Sergel1/dispolays/cad/Dispolays_kicad.step

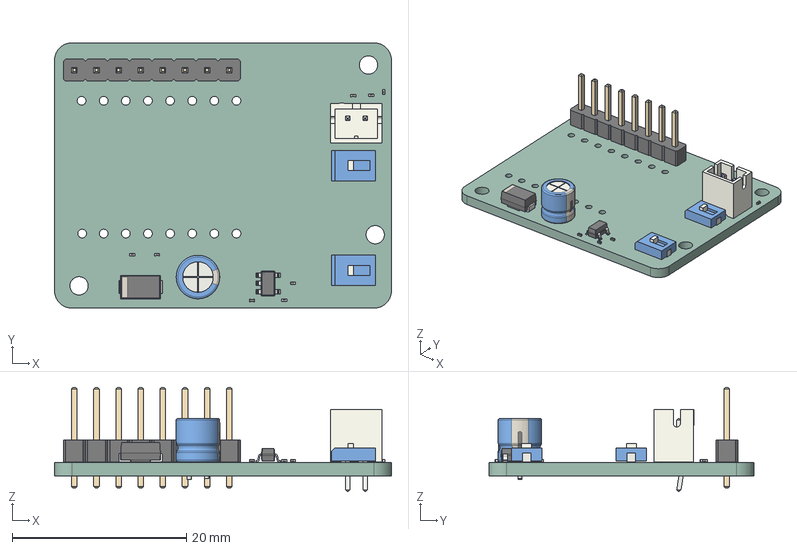
[picture p6: CAD file, 2026-11-02]
cad/Dispolays_kicad.step
38.7 x 30.5 x 11.9 mm
C_0201_0603Metric x 8
PinHeader_1x08_P254mm_Vertical
SOT-23-5
SW_SPST_EVQPE002 x 2
SW_SPST_EVQPE1 x 2
JST_B2B_PH_K
CP_Radial_D50mm_P200mm
D_SMA
Dis4F0D_PCB
