Sergel1/dispolays/cad/Dispolays_Enclosure_Master_front-shell.SLDPRT

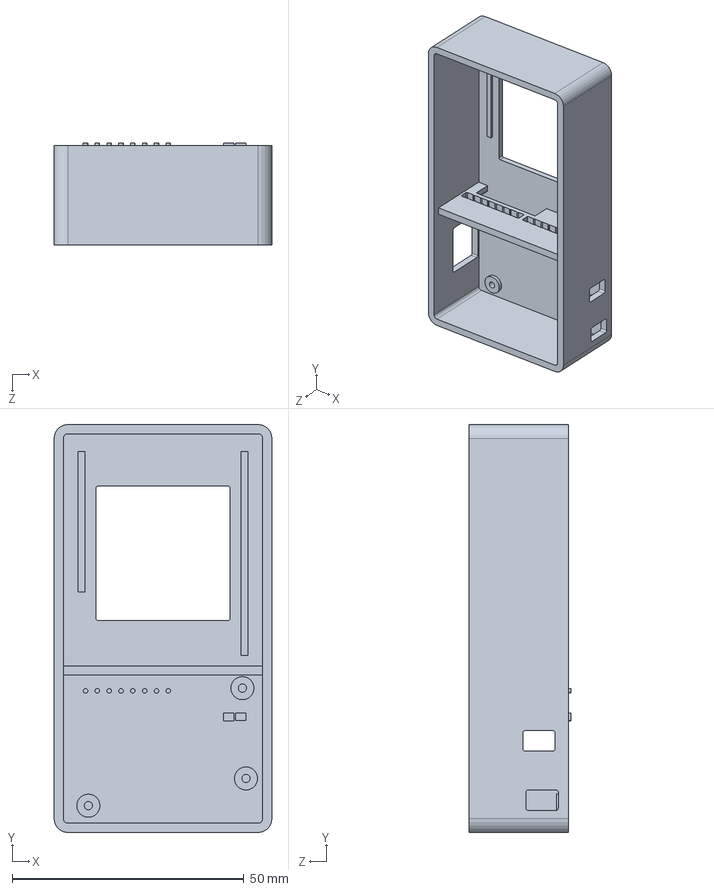
[picture p7: CAD file, 2026-11-02]
cad/Dispolays_Enclosure_Master_front-shell.SLDPRT
47.0 x 88.0 x 22.0 mm
