Sergel1/dispolays/cad/Dispolays_Enclosure_Assembly.SLDASM

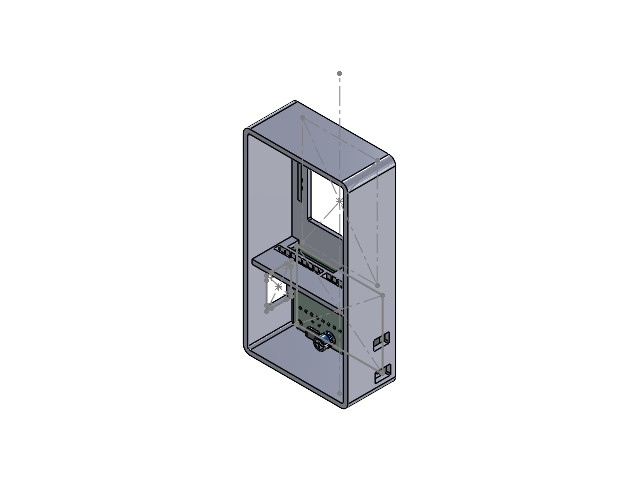
[picture p8: CAD file, 2026-11-02]
cad/Dispolays_Enclosure_Assembly.SLDASM
C_0201_0603Metric-0.step x 8
PinHeader_1x08_P254mm_Vertical.step
SOT-23-5-1.step
SW_SPST_EVQPE002.step x 2
Shape0_306752862737.step x 2
Shape0_0812142154717.step x 2
SW_SPST_EVQPE1-2.step x 2
JST_B2B_PH_K.step
CP_Radial_D50mm_P200mm.step
D_SMA-3.step
Dis4F0D_PCB.step
Dispolays_Enclosure_Master_front-shell
Part12^Dispolays_Enclosure_Assembly
Part13^Dispolays_Enclosure_Assembly
Part14^Dispolays_Enclosure_Assembly
