Sergel1/dispolays/hardware/Disployas_week4.kicad_pcb

## KiCad design hardware/Disployas_week4.kicad_pcb (2026-11-02)

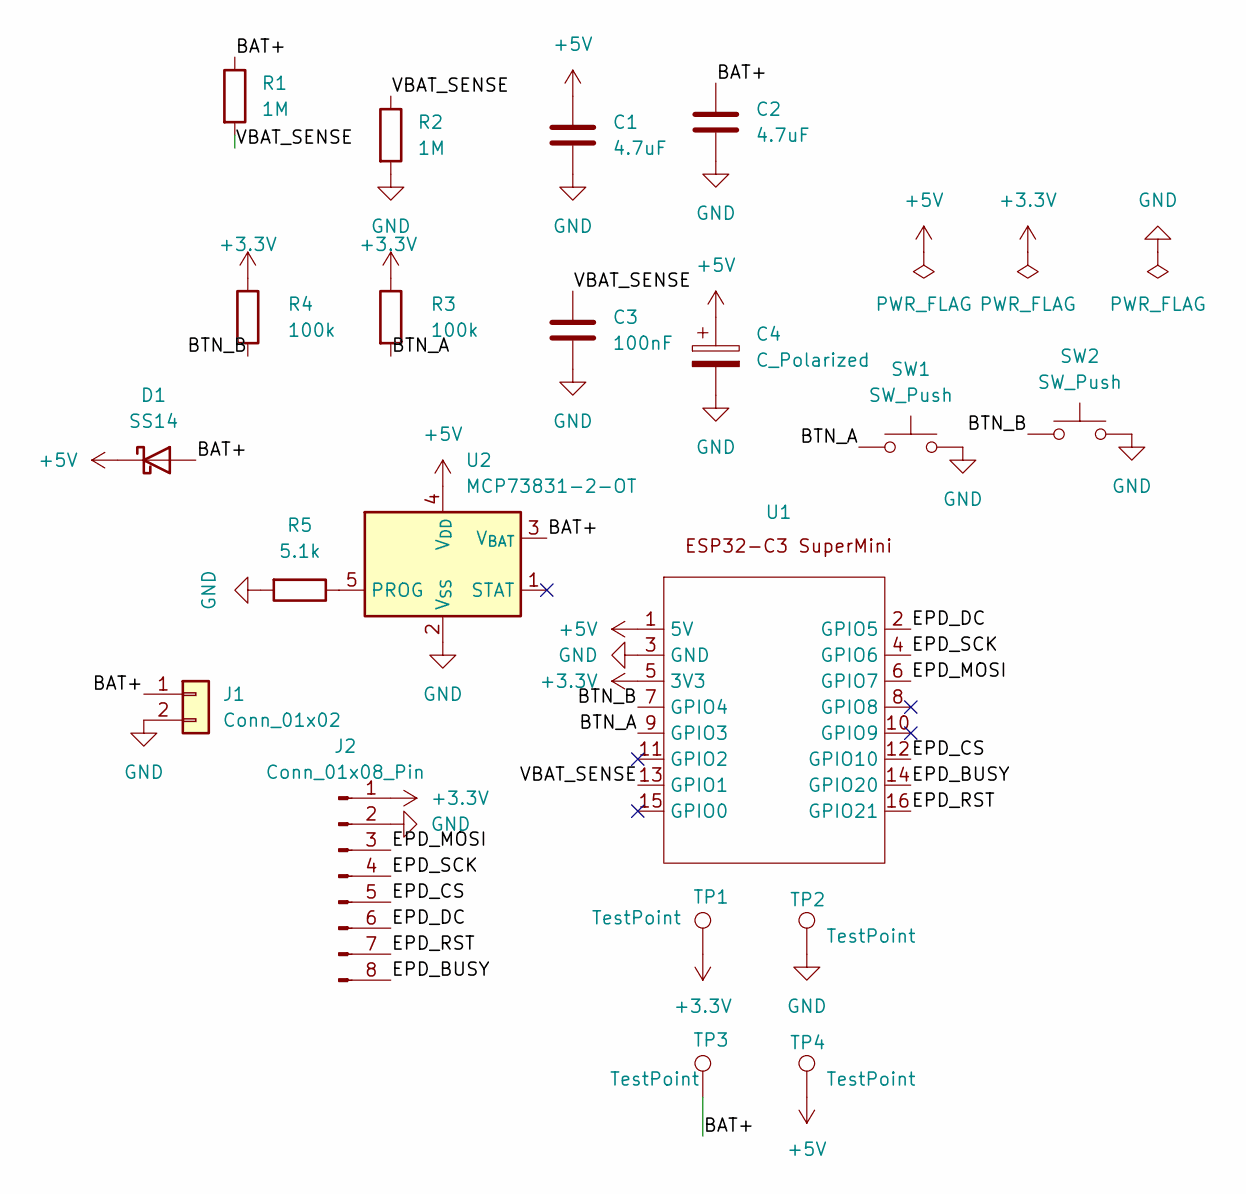
[picture p9: schematic Disployas_week4_schematics.kicad_sch]

Parts:
C1, C2: 4.7uF; C_0201_0603Metric
C3: 100nF; C_0201_0603Metric
C4: C_Polarized; CP_Radial_D5.0mm_P2.00mm
D1: SS14; D_SMA
J1: Conn_01x02; JST_PH_B2B-PH-K_1x02_P2.00mm_Vertical
J2: Conn_01x08_Pin; PinHeader_1x08_P2.54mm_Vertical
R1, R2: 1M; C_0201_0603Metric
R3, R4: 100k; C_0201_0603Metric
R5: 5.1k; C_0201_0603Metric
SW1, SW2: SW_Push; SW_SPST_EVQPE1
TP1, TP2, TP3, TP4: TestPoint; TestPoint_Pad_D1.5mm
U1: ESP32-C3_SuperMini_2x08
U2: MCP73831-2-OT; SOT-23-5

Connections:
+3.3V: J2.1, R3.1, R4.1, TP1.1 (1_1), U1.5 (3V3)
+5V: C1.1, C4.1, D1.1 (K), TP4.1 (1_1), U1.1 (5V), U2.4 (V_{DD})
/BAT+: C2.1, D1.2 (A), J1.1, R1.1, TP3.1 (1_1), U2.3 (V_{BAT})
/BTN_A: R3.2, SW1.1, U1.9 (GPIO3)
/BTN_B: R4.2, SW2.1, U1.7 (GPIO4)
/EPD_BUSY: J2.8, U1.14 (GPIO20)
/EPD_CS: J2.5, U1.12 (GPIO10)
/EPD_DC: J2.6, U1.2 (GPIO5)
/EPD_MOSI: J2.3, U1.6 (GPIO7)
/EPD_RST: J2.7, U1.16 (GPIO21)
/EPD_SCK: J2.4, U1.4 (GPIO6)
/VBAT_SENSE: C3.1, R1.2, R2.1, U1.13 (GPIO1)
GND: C1.2, C2.2, C3.2, C4.2, J1.2, J2.2, R2.2, R5.2, SW1.2, SW2.2, TP2.1 (1_1), U1.3 (GND), U2.2 (V_{SS})
unnamed: R5.1, U2.5 (PROG)

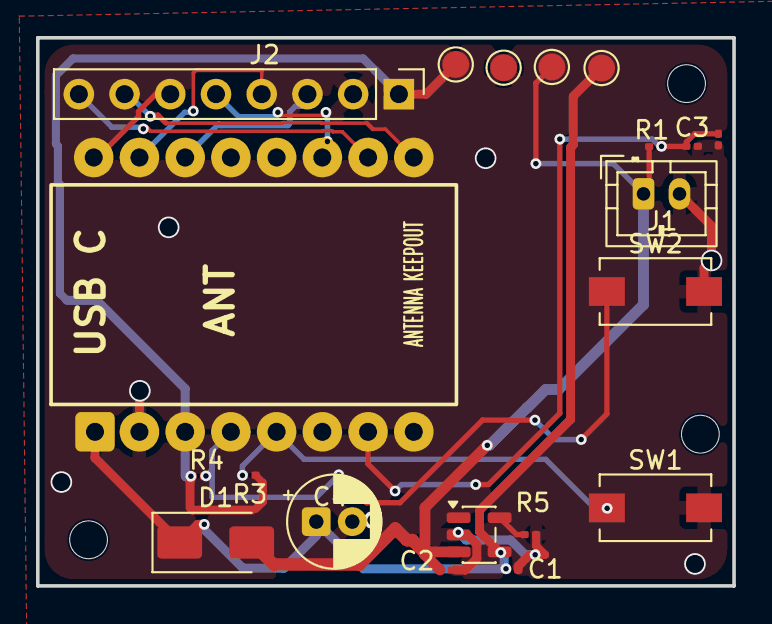
[picture p10: board Disployas_week4.kicad_pcb from above]

Board: 2 copper layers, 38.7 x 30.5 mm, 20 parts (0 on the bottom side), 14 nets.
