Sergel1/dispolays/(commit log)

2026-11-02 Create kicad-project
2026-11-02 Rename Disployas week4-NPTH.drl to Disployas_week4-NPTH.drl
    [Disployas_week4-NPTH.drl]
2026-11-02 Rename Disployas week4.kicad_pcb to Disployas_week4.kicad_pcb
    [Disployas_week4.kicad_pcb]
2026-11-02 Rename Disployas week4.kicad_pro to Disployas_week4.kicad_pro
2026-11-02 Rename Disployas week4-PTH.drl to Disployas_week4-PTH.drl
    [Disployas_week4-PTH.drl]
2026-11-02 Revise README for Week 4 project updates
    Updated project overview, system overview, and design sections to reflect changes made during Week 4. Added details on completed tasks, enclosure design, and safety notes.
